XaviCanoFerrer/Grasp_Bionic_Hand/README.md

# Grasp_Bionic_Hand
Grasp is a 3D printable, 6 DOF bionic hand based on the Arduino Nano micro-controller.

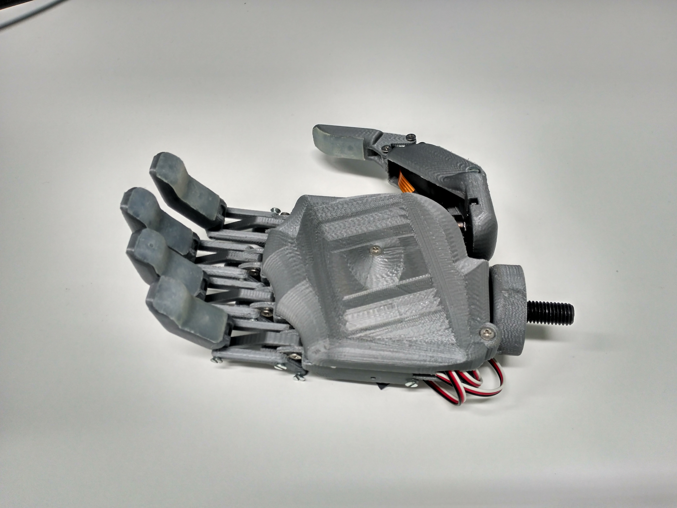
[picture p1: IMG_20190316_192310 (1).jpg]
