XaviCanoFerrer/Grasp_Bionic_Hand/Poster.pdf

## Effective mechanical design

Grasp is a 6 degrees of freedom bionic hand based on the Arduino Nano micro-controller. The main design motivation behind this project is to achieve an affordable prosthetic hand able to do the most important types of grasps for the activities of daily living with competitive fingertip forces and flexion-extension speed values Also, it can be used for different purposes: robotics, research, education, hobby. The present work contains the explanation of the theoretical design process and also the evaluation of a fully working prototype.

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
0 | 20000 | 40000 | 60000 | 80000 | 100000

max von Mises (MPa)

nnodes

Convergence study

The project has been published on a website, Thingiverse and Hackaday where the 3D printable parts can be free downloaded. The assembly instructions and the bill of materials is also available in these platforms. Nowadays the downloads of the different designs of the project are more than 1000.

Summary of Grasp 1.0 features
Flexion-extension speed (°/s) | 71.96
Opposition speed (°/s) | 196.10
Finger fingertip force (N) | 6.82
Thumb fingertip force (N) | 16.50
Mass (g) | 335
DOF | 6
Size (mm) | 190 x 141 x 53
Cost (€) | 477.35

0

4

8

12

16

Be bionic

iLimb
Vincent Hand
Michelangelo
Dextrus

Tact

Transmetacarpal

Hand

Grasp

Commercial | Open source

N

Fingertip force

Minimum Maximum

0

50

100

150

200

250

300

Be bionic
iLimb
Vincent Hand

Michelangelo
Dextrus

Tact
Transmetacarpal

Hand

Grasp

Commercial | Open source

°/s

Finger flexion-extension speed

Minimum Maximum

Design and development of an open source, 3D printable, bionic hand.

### Xavier Cano Ferrer

## Grasp features

## Human interface and control algorithm

Objectives | Electronics included on the palm

## Open source project

## Introduction

## Project evolution

EMG_Flexion =

−107
ma x _ subject
- EMG2 + 145

## Effective mechanical design

Grasp is a 6 degrees of freedom bionic hand based on the Arduino Nano micro-controller. The main design motivation behind this project is to achieve an affordable prosthetic hand able to do the most important types of grasps for the activities of daily living with competitive fingertip forces and flexion-extension speed values Also, it can be used for different purposes: robotics, research, education, hobby. The present work contains the explanation of the theoretical design process and also the evaluation of a fully working prototype.

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
0 | 20000 | 40000 | 60000 | 80000 | 100000

max von Mises (MPa)

nnodes

Convergence study

The project has been published on a website, Thingiverse and Hackaday where the 3D printable parts can be free downloaded. The assembly instructions and the bill of materials is also available in these platforms. Nowadays the downloads of the different designs of the project are more than 1000.

Summary of Grasp 1.0 features
Flexion-extension speed (°/s) | 71.96
Opposition speed (°/s) | 196.10
Finger fingertip force (N) | 6.82
Thumb fingertip force (N) | 16.50
Mass (g) | 335
DOF | 6
Size (mm) | 190 x 141 x 53
Cost (€) | 477.35

0

4

8

12

16

Be bionic

iLimb
Vincent Hand
Michelangelo
Dextrus

Tact

Transmetacarpal

Hand

Grasp

Commercial | Open source

N

Fingertip force

Minimum Maximum

0

50

100

150

200

250

300

Be bionic
iLimb
Vincent Hand

Michelangelo
Dextrus

Tact
Transmetacarpal

Hand

Grasp

Commercial | Open source

°/s

Finger flexion-extension speed

Minimum Maximum

Design and development of an open source, 3D printable, bionic hand.

### Xavier Cano Ferrer

## Grasp features

## Human interface and control algorithm

Objectives | Electronics included on the palm

## Open source project

## Introduction

## Project evolution

EMG_Flexion =

−107
ma x _ subject
- EMG2 + 145
