XaviCanoFerrer/Grasp_Bionic_Hand/Back render max quality .JPG

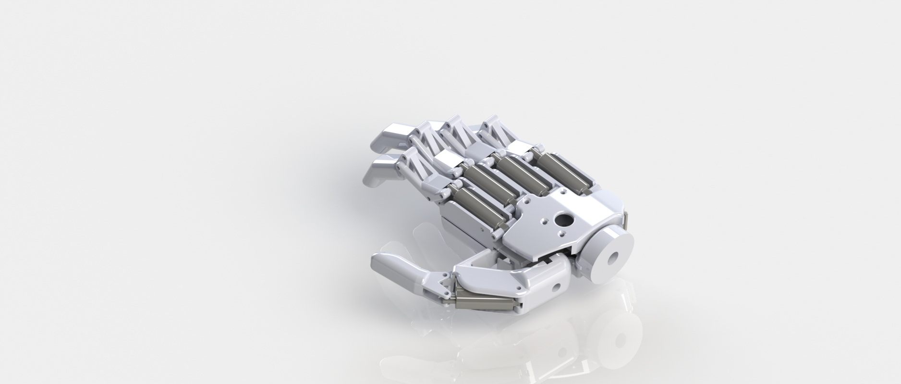
Back render max quality .JPG
