XaviCanoFerrer/Grasp_Bionic_Hand/Render max quality.JPG

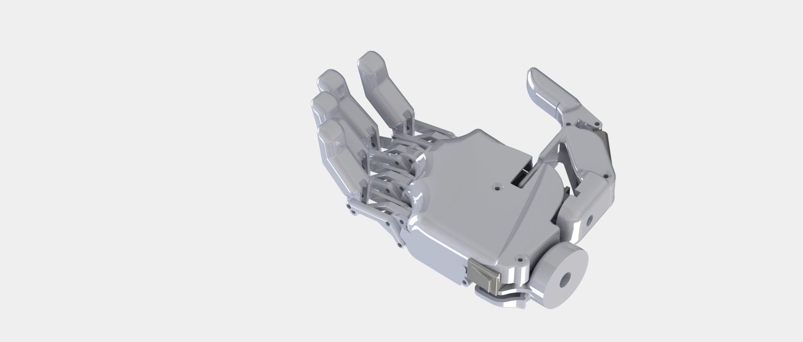
Render max quality.JPG
