XaviCanoFerrer/Grasp_Bionic_Hand/STEP files/Finger distal phalanx.stp

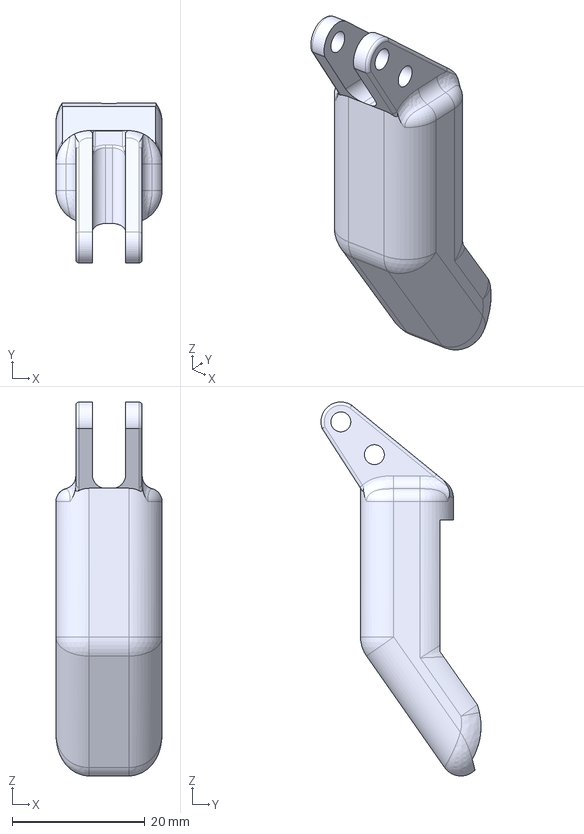
[picture p4: CAD file, 2021-07-24]
STEP files/Finger distal phalanx.stp
16.0 x 24.1 x 56.4 mm
