XaviCanoFerrer/Grasp_Bionic_Hand/STL files/Thumb mold1.STL

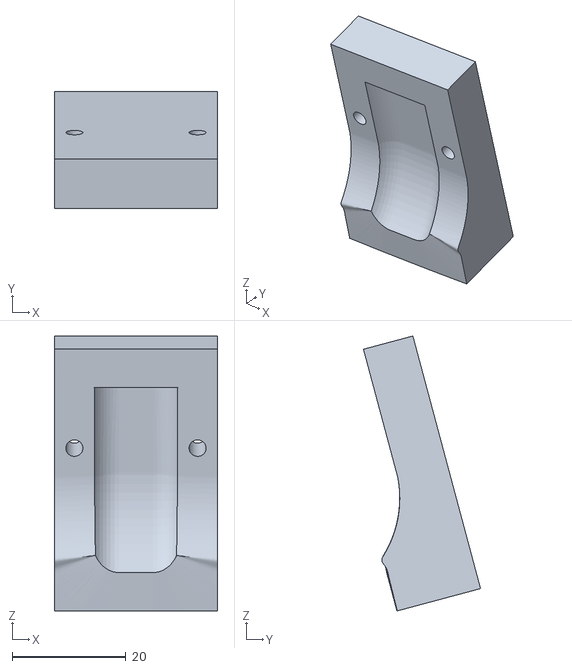
[picture p5: CAD file, 2021-07-24]
STL files/Thumb mold1.STL
28.7 x 20.6 x 48.4
