XaviCanoFerrer/Grasp_Bionic_Hand/STEP files/Body_Actuonix_PQ12.stp

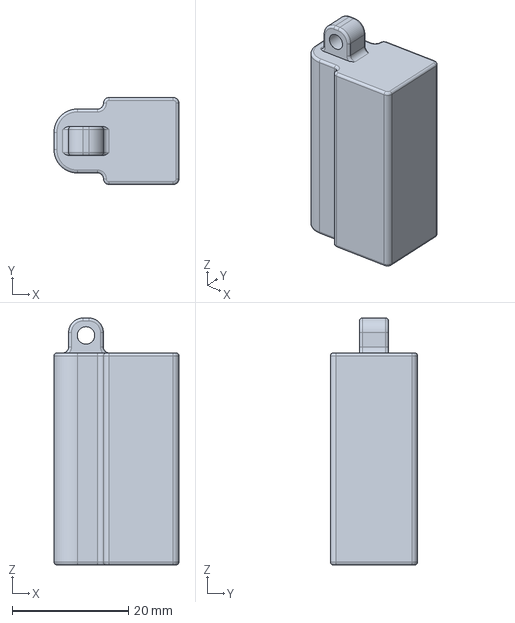
[picture p6: CAD file, 2021-07-24]
STEP files/Body_Actuonix_PQ12.stp
21.5 x 15.0 x 42.5 mm
