XaviCanoFerrer/Grasp_Bionic_Hand/STL files/Hand exposition base.STL

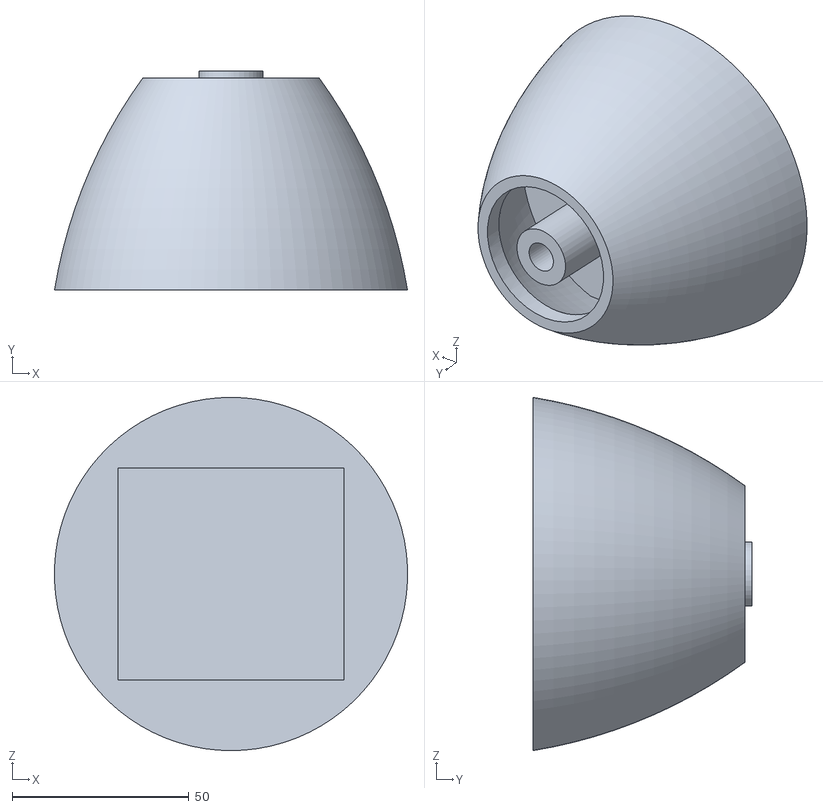
[picture p7: CAD file, 2021-07-24]
STL files/Hand exposition base.STL
99.9 x 62.0 x 100.0
