XaviCanoFerrer/Grasp_Bionic_Hand/STEP files/Switch.stp

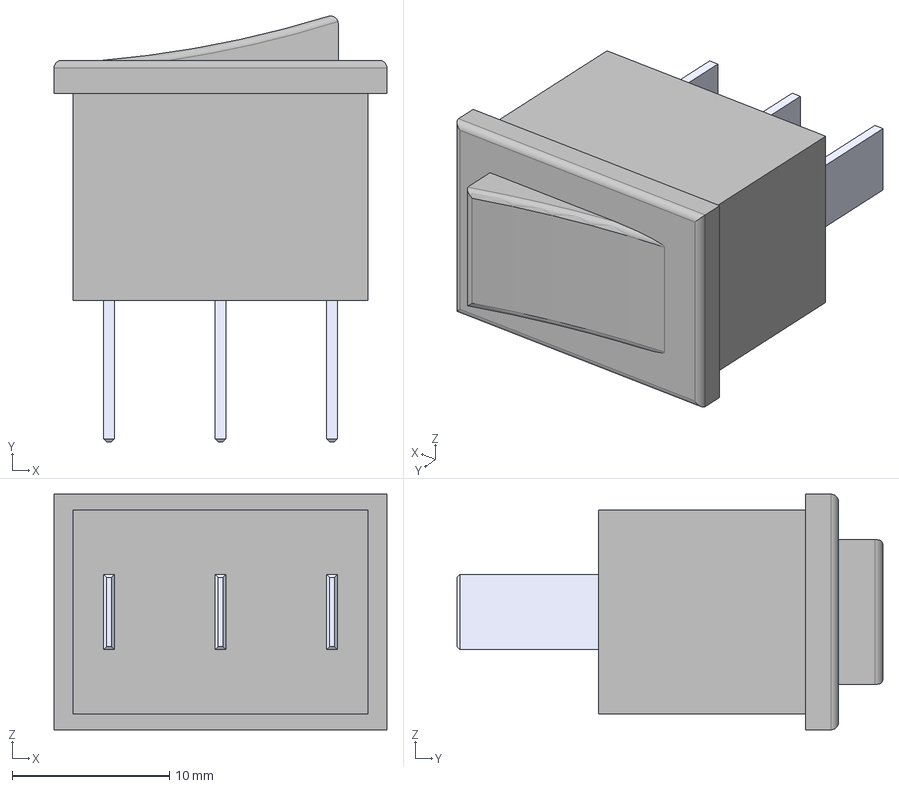
[picture p8: CAD file, 2021-07-24]
STEP files/Switch.stp
21.2 x 27.1 x 15.0 mm
