XaviCanoFerrer/Grasp_Bionic_Hand/STL files/Finger mold1.STL

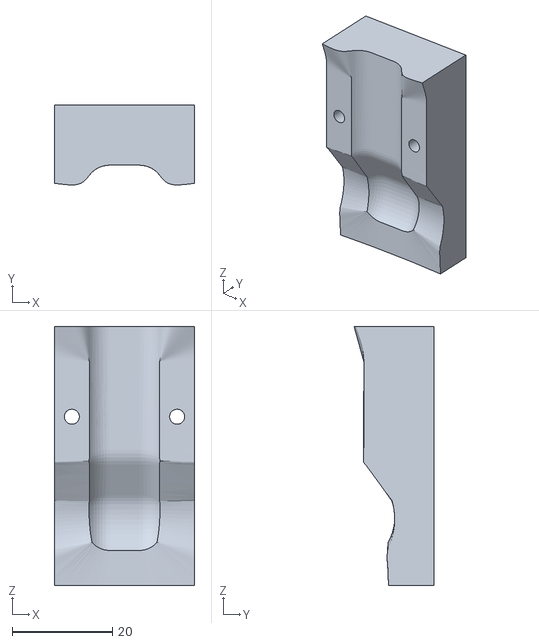
[picture p9: CAD file, 2021-07-24]
STL files/Finger mold1.STL
28.0 x 15.9 x 51.7
