XaviCanoFerrer/Grasp_Bionic_Hand/STEP files/Thumb_core_2.stp

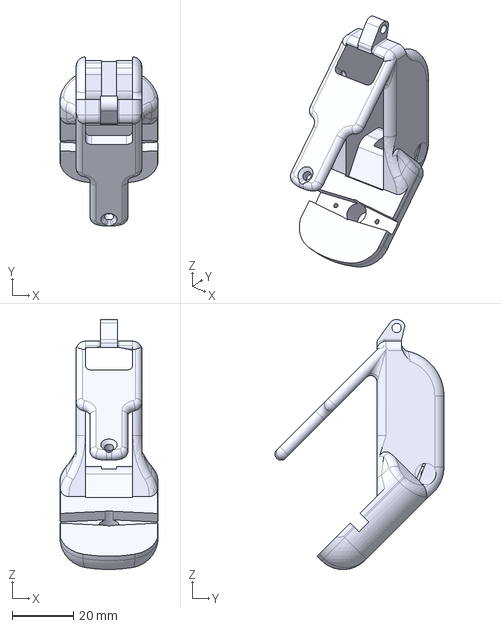
[picture p10: CAD file, 2021-07-24]
STEP files/Thumb_core_2.stp
32.2 x 55.4 x 81.9 mm
