XaviCanoFerrer/Grasp_Bionic_Hand/STL files/Thumb mold2.STL

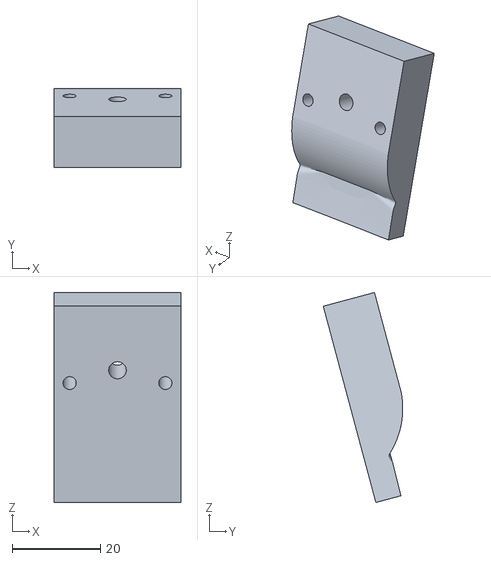
[picture p11: CAD file, 2021-07-24]
STL files/Thumb mold2.STL
28.7 x 18.0 x 47.5
