XaviCanoFerrer/Grasp_Bionic_Hand/STEP files/Actuator_actuonix_PQ12R.stp

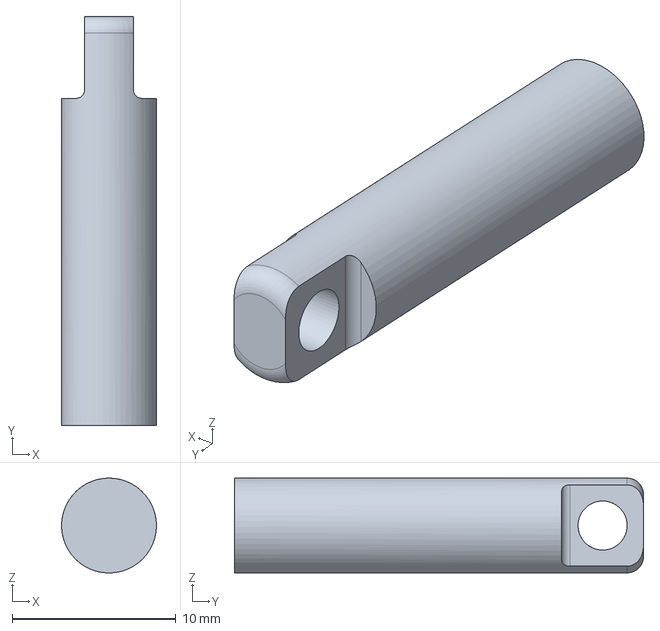
[picture p12: CAD file, 2021-07-24]
STEP files/Actuator_actuonix_PQ12R.stp
5.80 x 25.0 x 5.79 mm
