XaviCanoFerrer/Grasp_Bionic_Hand/STEP files/Finger distal phalanx silicone part.stp

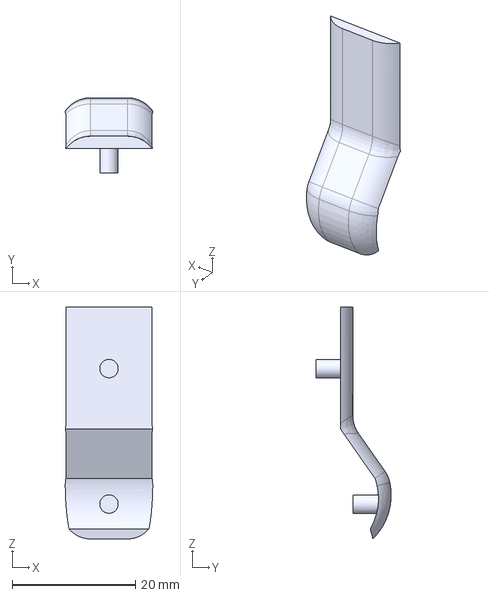
[picture p13: CAD file, 2021-07-24]
STEP files/Finger distal phalanx silicone part.stp
14.2 x 12.2 x 37.7 mm
