XaviCanoFerrer/Grasp_Bionic_Hand/STL files/Finger mold2.STL

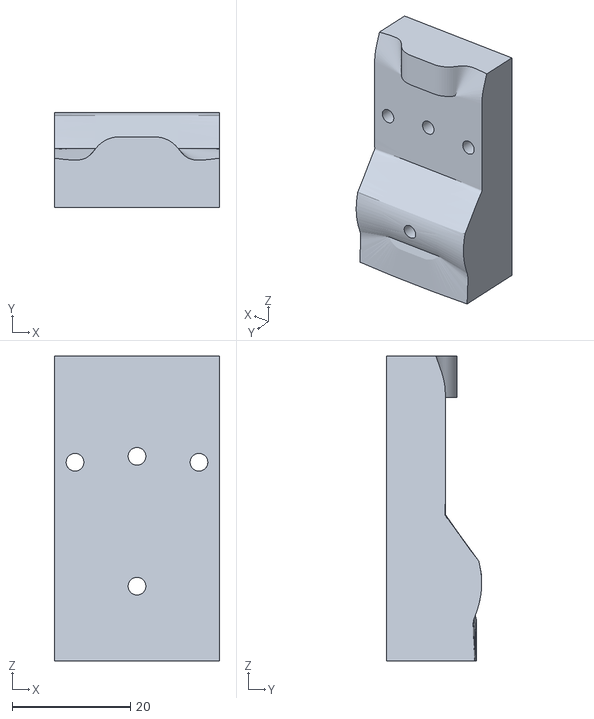
[picture p14: CAD file, 2021-07-24]
STL files/Finger mold2.STL
28.0 x 16.2 x 51.7
