XaviCanoFerrer/Grasp_Bionic_Hand/STEP files/Thumb distal phalanx silicone cover.stp

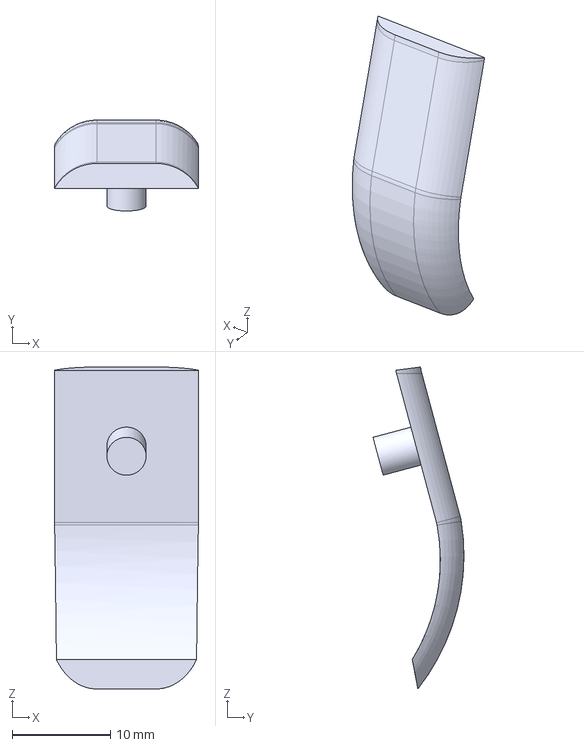
[picture p15: CAD file, 2021-07-24]
STEP files/Thumb distal phalanx silicone cover.stp
14.7 x 9.28 x 32.8 mm
