XaviCanoFerrer/Grasp_Bionic_Hand/STEP files/Top cover.stp

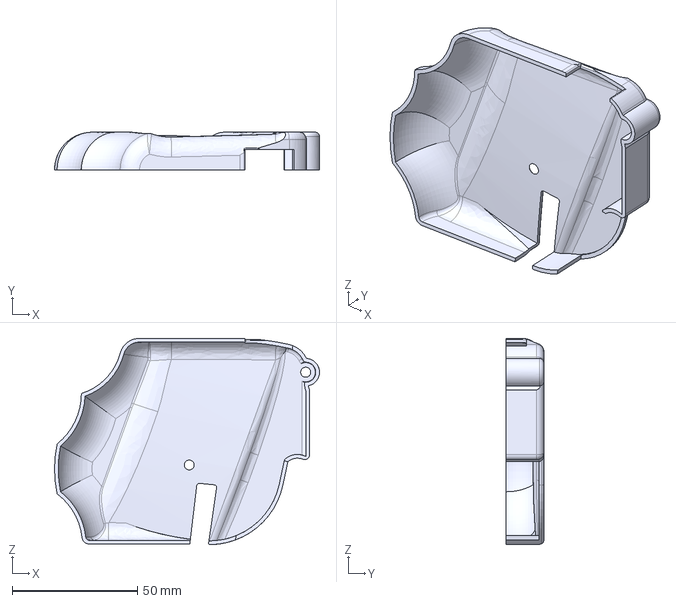
[picture p16: CAD file, 2021-07-24]
STEP files/Top cover.stp
105.6 x 15.0 x 82.2 mm
