XaviCanoFerrer/Grasp_Bionic_Hand/STEP files/MG90s_servo.stp

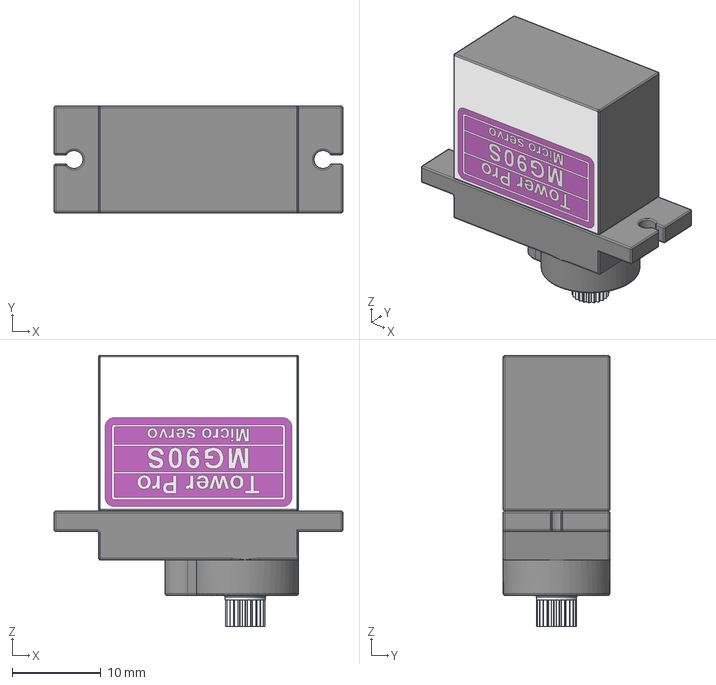
[picture p17: CAD file, 2021-07-24]
STEP files/MG90s_servo.stp
32.5 x 12.0 x 30.5 mm
