XaviCanoFerrer/Grasp_Bionic_Hand/STEP files/Thumb distal phalanx.stp

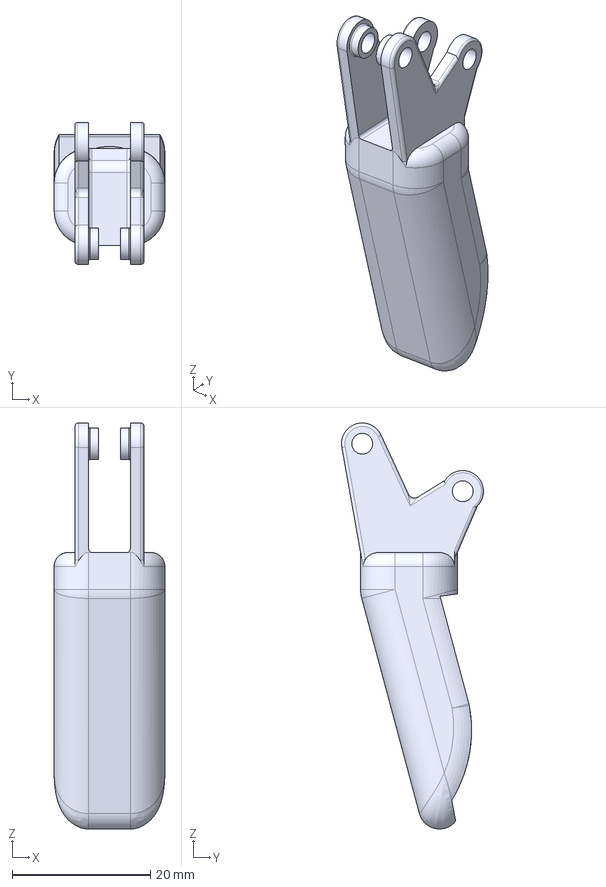
[picture p18: CAD file, 2021-07-24]
STEP files/Thumb distal phalanx.stp
16.0 x 20.5 x 58.7 mm
