XaviCanoFerrer/Grasp_Bionic_Hand/STEP files/Bottom cover.stp

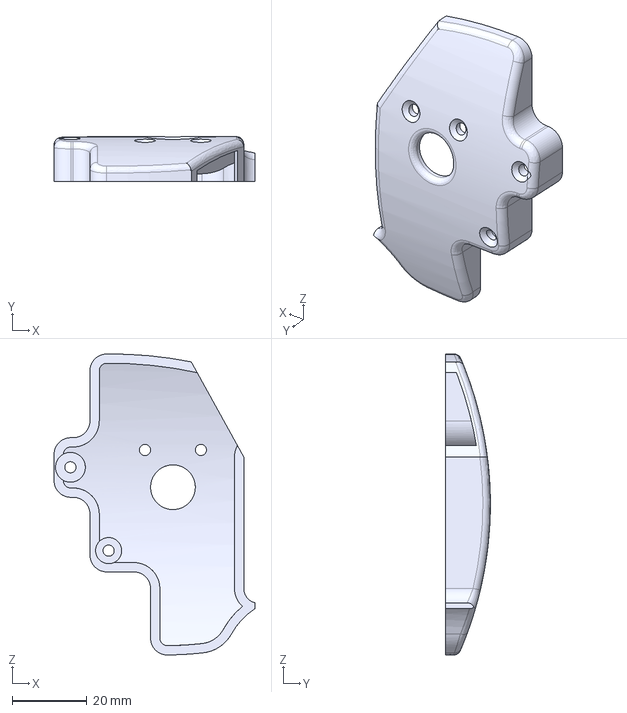
[picture p19: CAD file, 2021-07-24]
STEP files/Bottom cover.stp
53.9 x 12.0 x 80.7 mm
