XaviCanoFerrer/Grasp_Bionic_Hand/STEP files/Joint.stp

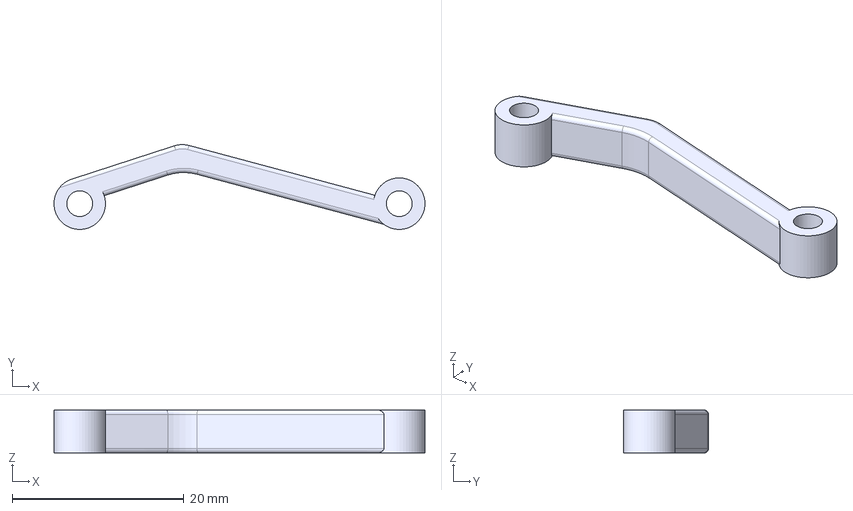
[picture p20: CAD file, 2021-07-24]
STEP files/Joint.stp
43.2 x 9.88 x 5.00 mm
