XaviCanoFerrer/Grasp_Bionic_Hand/STEP files/Palm.stp

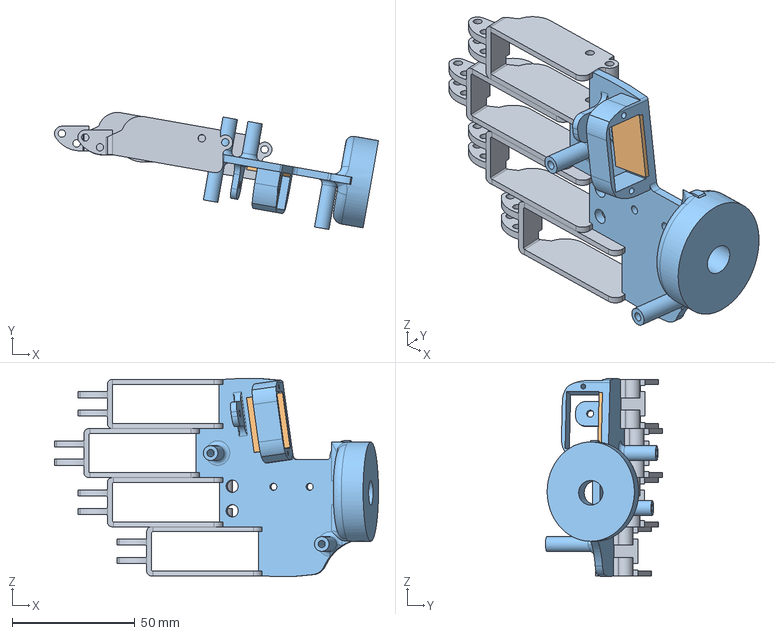
[picture p21: CAD file, 2021-07-24]
STEP files/Palm.stp
131.8 x 47.6 x 80.7 mm
