XaviCanoFerrer/Grasp_Bionic_Hand/STEP files/Finger proximal phalanx.stp

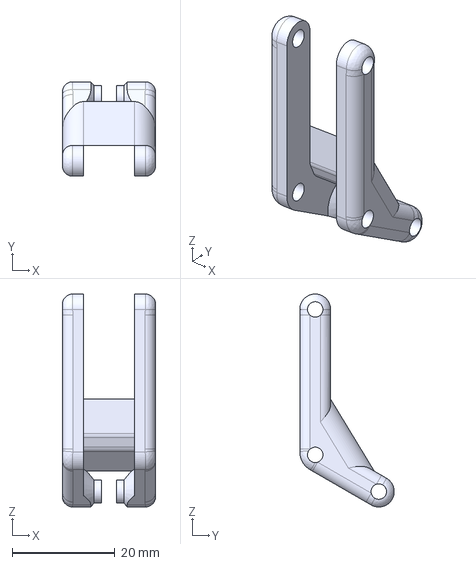
[picture p22: CAD file, 2021-07-24]
STEP files/Finger proximal phalanx.stp
18.0 x 18.4 x 41.4 mm
