XaviCanoFerrer/Grasp_Bionic_Hand/(list of files, cad)

Other CAD files:
STL files/Thumb_core.STL
STL files/Bottom cover.STL
STL files/Finger distal phalanx.STL
STL files/Finger proximal phalanx.STL
STL files/Joint.STL
STL files/Palm.STL
STL files/Thumb distal phalanx.STL
STL files/Top cover.STL
